segfault610/OneTOPS/docs/PROGRESS.md

# OneTOPS: Overall Progress

Last updated: 2026-10-14 (Rev D). All numbers are from simulation in sky130A with ngspice-46.
Conditions are TT, 27 °C, VIN = 1.8 V, VREF = 1.2 V, on-chip C_L = 20 pF unless stated otherwise.

## Status against the proposal plan

| Phase (proposal) | Period | Status |
|---|---|---|
| 1. Literature, PDK/device characterization, specs | Aug–Sep 2026 | **Done (sky130)**: gm/Id tables, pass-device study, spec set below. Literature list in `LITERATURE_SURVEY.md` |
| 2. Baseline FVF + adaptive bias + transient assist + DVS | Oct–Dec 2026 | **In progress.** Baseline ✔, transient boost ✔ (Rev C), DVS DAC + controller ✔, adaptive bias ☐ |
| 3. AMS / PVT / stability / PSRR / workload optimization | Jan–Mar 2027 | Started early: PVT sweep, Tian stability, workload TB exist |
| 4. Layout, integration, PEX | Apr–May 2027 | ☐ |
| 5. DRC/LVS/ERC, AMS sign-off, GDS / tapeout | Jun–Jul 2027 | ☐ (target: Tiny Tapeout sky130 shuttle) |
| 6. Silicon bring-up | Aug 2027+ | ☐ |

## Target specification (sky130 / Tiny Tapeout version)

*These targets are proposed, not agreed. Confirm them with the mentors before treating them as sign-off criteria.*

| Parameter | Target | Rev D (now) |
|---|---|---|
| VIN | 1.62–1.98 V | ✔ (regulates; see open issue 1 for hot, light load) |
| VOUT (DVS) | 1.00–1.45 V, 16 codes, 30 mV | ✔ monotonic; **+12…15 mV offset** |
| Load range | 0–10 mA | ✔ 10 µA–10 mA (≥ 1 mA at 125 °C / 1.98 V) |
| On-chip C_L | ≤ 20–30 pF | 20 pF |
| PM (all loads, PVT) | ≥ 45° | ✔ 84.7° TT; ✘ 25.2° worst valid PVT (fs/ff 125 °C light load, issue 1) |
| Undershoot, 0.1→10 mA, 100 ns | ≤ 100 mV | ✘ 118 mV TT (150 mV PVT worst); Rev C 98 mV |
| Undershoot, 10 ns edge | ≤ 150 mV | ✘ 254 mV TT |
| Overshoot, 10→0.1 mA, 100 ns | ≤ 100 mV | ✘ 130 mV TT (162 mV PVT worst) |
| Load regulation | ≤ 2 mV/mA | ✔ 1.07 mV/mA |
| Line regulation | ≤ 10 mV/V | ✘ 24 mV/V |
| PSRR @ 1 kHz / 1 MHz | ≤ −40 / −20 dB | ✘ −29…−32 / ✘ −10 dB light load (−22 dB at 10 mA) |
| Iq | ≤ 150 µA (stretch 50 µA) | ≈ 163 µA (Rev C 270 µA) |
| Area | ≤ 2×2 TT tiles | not laid out yet |

## Revision history

| Rev | Date | Change | Key result |
|---|---|---|---|
| A0 | 2026-10-14 | Flat hand netlist, ideal VREF supplies the replica, C_L 100 pF, Cc 12 pF (`sim/ref_a0_flat`) | Loop works; PM ≥ 48° at 10 µA–10 mA |
| A | 2026-10-14 | Hierarchical xschem library generated by `gen_xschem.py`; `vset_gen` OTA replica loop so the R-DAC can drive VREF directly | DVS 16 codes monotonic; −295 / +149 mV for a 100 ns step |
| B | 2026-10-14 | Tiny Tapeout sizing: C_L 20 pF, Cc 4 pF; `decap`, `load_emu`, `chip_top` (L4); `dvs_ctrl.sv` | PM ≥ 55.8° (TT); −171 / +113 mV; **workload dip 537 mV** at 10 ns edges |
| C | 2026-10-14 | **`tr_boost`**: undershoot booster (UB), dynamic bleeder (OB), X pull-up (OBX), `ben` enable | **Undershoot −42 % (100 ns) / −50 % (10 ns); workload dip 536 → 329 mV; PM 55.8° → 74.8° (TT)** |
| D | 2026-10-14 | **`ab_sense` adaptive bias**: MC + replica bias = 5 µA + I_load/500 (1/500 pass replica); bleeder 100 → 40 µA | **Iq 270 → 163 µA**, PM 84.7° TT, line reg 24 mV/V; transient slightly worse (−118 / +130 mV @ 100 ns); hot-corner PM 25° (issue 1) |

Rev B → Rev C, TT, side by side (`ben` = 0 reproduces Rev B behavior on the same netlist):

| Metric | boost off | **boost on** |
|---|---|---|
| Undershoot 100 ns / 10 ns edge | 170 / 472 mV | **98 / 234 mV** |
| Overshoot 100 ns / 10 ns edge | 105 / 258 mV | 107 / 260 mV |
| Workload inference dip (1.3 → 9.6 mA, 10 ns) | 536 mV | **329 mV** |
| PVT worst undershoot, 100 ns / 10 ns | 245 / 561 mV | **127 / 296 mV** |
| Iq | 221 µA (Rev B) | 270 µA |

**Correction (2026-10-14):** the first Rev C report gave a workload dip of 258 mV and 221 mV for
the 10 ns step. Those runs had no transient max-step, so ngspice under-resolved the 10 ns load edges.
Every transient testbench now sets one (0.5–10 ns); the corrected values are in the tables above.

Also added in Rev C: **mixed-signal co-simulation**. `dvs_ctrl.sv` is compiled by Verilator and
runs inside ngspice through XSPICE `d_cosim` (`tb_ams_dvs_ctrl`). The real RTL ramps the code and
pre-boosts on the workload hint: 7 → 10 → 4, VOUT 1.226 → 1.315 → 1.142 V, burst dip 341 mV.

## Open issues (priority order)

1. **Hot, light-load regulation loss (pre-existing since Rev A/B).** At 125 °C with VIN = 1.98 V
   and load ≤ 100 µA (≤ 1 mA at fs), the leakage of the 700 µm pass device exceeds the 100 µA bleeder.
   Because the FVF clamps X below VOUT − Vsd(MC), the pass gate can't rise far enough to shut it
   off, and VOUT drifts up by 120–150 mV. Corner runs show this as wrapped PM (~390°), which
   `scripts/corner_summary.py` now flags as INVALID.
   An earlier Rev B report missed it: that summary only took the minimum PM.
   Rev D's smaller bleeder (40 µA) moves the onset in: PM is 25–47° at fs/ff, 125 °C, 1.8 V, light load.
   *Tried and rejected (Rev D study):* a fixed-shift source-follower gate buffer (X's 0.85 V window can't
   cover both "off" and "10 mA"); a longer-L pass device (0.5 / 0.7 µm: leakage barely improves, transient much worse);
   a bigger bleeder (80 µA only gives 33° at fs/125 °C).
   *Remaining fixes:* (a) an overvoltage **shunt clamp** (slow OTA, VOUT vs VREF + ~40 mV, drives an NMOS
   sink; costs only the leakage it absorbs); (b) a non-inverting **gain-stage gate driver**
   (Huang & Cheng, ICET 2023), which widens the gate range to VIN and raises loop gain (PSRR, line reg)
   but adds a pole.
2. **Overshoot at fast load release** is C_L-limited: VOUT peaks within the 10 ns edge, and the
   pass gate is already cut off in about 15 ns. The OBX pull-up gives only about 3 %.
   *Options:* more C_L in the remaining area, a direct output discharge clamp, workload-hint driven pre-bias.
3. **+12–15 mV DC offset** (MC/MR Vds mismatch + 5T OTA systematic offset).
4. **Iq ≈ 163 µA** after adaptive bias (Rev D). Remaining big items: OTA tail 40, bleeder 40, UB 30, reference 20.
5. PSRR / line regulation limited by the single-stage FVF (≈ 1/(g_mc·R_X)).
6. Ideal R/C still in `comp_rc`, `decap`, `rdac4`, `tr_boost` (Rb = 1 MΩ needs a pseudo-resistor).

## Next steps

1. Fix issue 1: shunt clamp first (smallest change), gain-stage driver as the alternative.
2. Use `dvs_ctrl.boost_en` (the workload hint) to raise the bias before bursts.
3. On-chip bias (beta multiplier) and VHI/VLO reference.
4. Real sky130 passives; Monte-Carlo mismatch on the dead zones and the replica.
5. Verilog-A behavioral models (OpenVAF/OSDI) for fast system-level sims; then layout → DRC/LVS/PEX → TT wrapper.
