segfault610/OneTOPS/Capacitorless LDO — Project Status.pptx

## Workload-Aware Capacitorless LDO with Adaptive Biasing

ANALOG / MIXED-SIGNAL IC DESIGN · PROJECT STATUS

A flipped-voltage-follower (FVF) based output-capacitorless regulator for bursty Edge-AI / AIoT power domains, designed in the open SkyWater sky130 PDK for a Tiny Tapeout shuttle.

Mentor: Dr. Jyotishman Saikia · Co-Mentor: Dr. Vaegae Naveen Kumar

Dept. of Micro and Nanoelectronics, SENSE

Phase 2 status · Oct 2026

## Where a fast, capacitorless LDO earns its place

TARGETED APPLICATIONS

Edge-AI sensor nodes

Stable local rails across sleep → sensing → inference → communication transitions.

Edge-AI cameras & agri/industrial sensing

Absorbs sudden current spikes from on-device image or signal processing bursts.

Mixed-signal SoCs

Shields sensitive analog and sensor front-ends from digital switching noise on a shared supply.

AIoT / dynamic voltage scaling

Fast, low-IQ wake-up stability for devices that scale voltage with workload.

Proposal §2.2 · Final application

## Workload-Aware Digitally Assisted Fast-Transient Capacitorless LDO with Adaptive Biasing for Edge-AI Systems

PROPOSED TOPIC

Hypothesis: adaptive biasing combined with a fast transient-boost path lets an output-capacitorless LDO respond faster to sudden load changes and stay energy-efficient, without a large external output capacitor — built and verified in SkyWater sky130 (open PDK), with a Tiny Tapeout shuttle as the tapeout route.

0–10mA

Target load range

No C_OUT

Output-capacitorless topology

4-bit

Digital voltage scaling (DVS)

## Four blocks, built up in order

OVERALL PROJECT PLAN

BUILT & VALIDATED

FVF + Pass Element

Flipped voltage follower driving the PMOS pass device — the base regulation loop.

BUILT · REV C

Transient-Boost Path

Detects sudden VOUT excursions and kicks extra drive onto the pass device.

BUILT · REV D

Adaptive Bias & Stability

Scales IBIAS with load to trade quiescent current for speed only when needed.

BUILT · RTL + AMS

4-bit DVS / Control

Digital output-voltage selection, plus a workload-hint input to pre-bias the loop.

- Devices characterized (gm/Id tables) and specs set
- Baseline FVF-only LDO kept as reference (boost off via ben pin)
- Transient boost, adaptive bias and DVS all built and simulated

- 45-point PVT sweep running; hot-corner leakage is the open issue
- Next: layout, PEX and AMS sign-off
- Characterize on silicon via a Tiny Tapeout shuttle

## PDK, flow and the four blocks

CURRENT PROGRESS

PDK & flow

SCL, TSMC22 and GF55 models unavailable; ICsprout55 ships no SPICE models

Chosen: SkyWater sky130 (open, silicon-proven), tapeout via Tiny Tapeout

xschem + ngspice: 18-cell library, levels L0–L4, one schematic + symbol per block

AMS: dvs_ctrl RTL runs inside ngspice (Verilator + d_cosim); PVT sweeps scripted

What's built

FVF loop + replica VSET generator: PM ≥ 85° (TT), 1.07 mV/mA load regulation

Transient boost: AC-coupled dip detector + ×20 gate pull-down, about halves undershoot

Adaptive bias: 1/500 pass replica makes loop bias track load; Iq 270 → 163 µA

4-bit DVS: R-DAC 1.00–1.45 V in 30 mV steps + slew-limited controller with workload hint

## Boost and adaptive bias: Rev D results

CURRENT PROGRESS · KEY FINDING

Metric | Without assist | Rev D (boost + adaptive bias)
Undershoot, 0.1 → 10 mA in 100 ns | 267 mV | 118 mV
Edge-AI burst, 1.3 → 9.6 mA in 10 ns | 534 mV | 334 mV
Quiescent current | 270 µA (fixed bias) | 163 µA

On the same netlist, the transient boost (switched by the ben pin) more than halves the 100 ns undershoot and cuts the Edge-AI burst dip by 37 %, while adaptive bias lowers standby current by 40 %. Trade-offs: light-load PSRR at 1 MHz drops about 10 dB, and phase margin falls to 25° at the hottest light-load corner, which is the next fix. The real dvs_ctrl RTL, co-simulated in ngspice, pre-raises VOUT on the workload hint before the burst.

sky130 TT · 27 °C · VIN 1.8 V · ngspice

## What we fix next

OPEN ISSUES & NEXT STEPS

01

Hot-corner leakage (125 °C, light load): add a shunt clamp or gain-stage driver

02

+12–15 mV DC offset across DVS codes: improve replica matching and OTA gain

03

PSRR (−30 dB at 1 kHz) and line regulation (24 mV/V) are limited by the single-stage FVF loop

04

Swap ideal R/C for sky130 MIM and poly devices; run Monte-Carlo mismatch

Layout → DRC / LVS / PEX → Tiny Tapeout analog submission (≤ 2×2 tiles)

05

## What the project delivers

EXPECTED OUTCOMES

01

A basic and an improved output-capacitorless LDO, both realized in the target process

02

A head-to-head comparison of fixed-bias, adaptive-bias, and fully-assisted designs on performance and power

03

Validation against Edge-AI workload current patterns: sleep, sensing, inference, communication

04

Complete layout with DRC / LVS / PEX / AMS verification, and a GDSII if the schedule allows

Silicon characterization on a Tiny Tapeout shuttle, otherwise sign-off by post-layout simulation

05

## One-year execution plan

PROJECT TIMELINE

Phase | Period | Activities
1 | Aug–Sep 2026 | Literature review, PDK / device characterization, specifications
2 — now | Oct–Dec 2026 | Baseline FVF + adaptive bias + transient assist + DVS
3 | Jan–Mar 2027 | AMS / PVT / stability / PSRR / workload optimization
4 | Apr–May 2027 | Custom layout, integration, PEX
5 | Jun–Jul 2027 | DRC / LVS / ERC, AMS sign-off, GDSII / tape-out
6 | Aug 2027 onward | Fabrication return, PCB bring-up, silicon characterization, report

Fabrication and silicon testing proceed only if the MPW shuttle schedule allows it.

One-year execution plan · proposal §3
