segfault610/OneTOPS/docs/guides/README.md

# User guides

| Guide | You want to… |
|---|---|
| [01_getting_started.md](01_getting_started.md) | set up, regenerate, and run every testbench in one command |
| [02_xschem_gui.md](02_xschem_gui.md) | open the schematics, browse the hierarchy, netlist and simulate from the GUI, place blocks as symbols in your own schematic |
| [03_testing_blocks.md](03_testing_blocks.md) | characterize one block at a time: what each testbench shows and what result to expect |
| [04_full_system_and_ams.md](04_full_system_and_ams.md) | simulate the whole chip, the Edge-AI workload demo, mixed-signal co-sim with the real RTL, and PVT corners |
| [05_modifying_the_design.md](05_modifying_the_design.md) | resize devices, add a block or testbench, keep docs and git up to date |
