segfault610/OneTOPS/(commit log)

2026-10-13 Baseline FVF capacitorless LDO in sky130: hierarchical xschem library, testbenches, DVS RTL
    - gm/Id and pass-device characterization (sim/char, scripts/gmid_table.py)
    - generated xschem cell library L0-L4 (scripts/gen_xschem.py): bias, vset_gen replica
    loop, FVF core, pass device, compensation, Tian probe, 4-bit R-DAC, decap, load emulator
    - testbench runner and PVT corner sweep (scripts/run_tb.sh, scripts/run_corners.sh)
    - Rev B sizing for Tiny Tapeout (CL 20 pF, Cc 4 pF): PM >= 55 deg over 45 PVT points
    - dvs_ctrl.sv slew-limited DVS controller with workload-hint pre-boost + self-checking TB
    - Rev A0 flat reference netlists kept in sim/ref_a0_flat
    [bias_mirror.sch, chip_top.sch, comp_rc.sch, decap.sch, fvf_core.sch, inv.sch, ldo_core.sch, ldo_top.sch]
2026-10-13 Add transient-boost path (Rev C): undershoot booster, dynamic bleeder, X pull-up
    - tr_boost cell: AC-coupled PMOS sensor with dead zone driving a x20 pull-down of
    pass-gate node X (UB), AC-coupled 100 uA bleeder (OB), NMOS-sensed x20 X pull-up (OBX)
    - ben pin threaded through ldo_core / ldo_top / chip_top for silicon A/B comparison
    - OBX mirror uses std-Vt PMOS: an LVT pull-up leaked >20 uA into X at 125 C
    - tran/workload testbenches sweep boost on/off and 100 ns / 10 ns load edges
    - corner_summary.py flags phase-wrapped (regulation-lost) PVT points as invalid
    - TT: undershoot 170->97 mV (100 ns), 472->221 mV (10 ns); workload dip 536->258 mV
    [bias_mirror.sch, chip_top.sch, ldo_core.sch, ldo_top.sch, tb_bias_mirror.sch, tb_chip_workload.sch, tb_ldo_core_ac.sch, tb_ldo_core_dc.sch]
2026-10-13 Add AMS co-simulation, interactive plots, user guides; fix transient timestep
    - dvs_ctrl RTL runs inside ngspice via Verilator + XSPICE d_cosim (scripts/build_ams.sh,
    tb_ams_dvs_ctrl): code 7 -> hint 10 -> 4, VOUT 1.226 -> 1.315 -> 1.142 V
    - every transient testbench now sets a max step; without it 10 ns load edges were
    under-resolved (workload dip read 258 mV, actually 329 mV). Docs corrected
    - testbenches open plots when run interactively from the xschem GUI (skipped in batch)
    - run_tb.sh tolerates xschem netlist warnings, builds the AMS library if missing
    - docs/guides: getting started, xschem GUI, per-block testing, full-system + AMS, modifying
    - papers/: PDFs git-ignored (copyright)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
    [tb_ams_dvs_ctrl.sch, tb_bias_mirror.sch, tb_chip_workload.sch, tb_ldo_core_ac.sch, tb_ldo_core_dc.sch, tb_ldo_core_tran.sch, tb_ldo_top_dvs.sch, tb_rdac4.sch]
2026-10-13 Add adaptive bias (Rev D): load-tracking MC and replica bias via 1/500 pass replica
    - ab_sense cell: pass replica senses Iload/500, adds it to the X-node sink and to the
    VSET replica path so VOUT does not shift; base bias 20 -> 5 uA; bleeder 100 -> 40 uA
    - TT: Iq 270 -> 163 uA, PM 84.7 deg @ 10 uA, line reg 24 mV/V, 10 ns overshoot 260 -> 250 mV;
    undershoot 98 -> 118 mV (100 ns), light-load PSRR @ 1 MHz -20 -> -10 dB
    - PVT: worst valid PM 25.2 deg at fs/125 C/1.8 V light load (onset of pass leakage, issue 1)
    - rejected in study: fixed-shift gate follower, longer-L pass, larger bleeder (documented)
    - tb_bias_mirror compliance check now relative (95 %) instead of a fixed 19 uA
    - docs: ab_s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
    [ab_sense.sch, bias_mirror.sch, ldo_core.sch, tb_bias_mirror.sch, tr_boost.sch]
2026-10-13 Update project status deck to Rev D
    - retarget PDK text to sky130 + Tiny Tapeout; block statuses (boost Rev C, adaptive bias Rev D, DVS RTL + AMS)
    - replace outdated results slide (5 V / 200 uA data) with Rev D boost/adaptive-bias comparison
    - rewrite progress slide (PDK, flow, built blocks); add open issues and next steps slide
